ezuercher/Simple-Analog-Temperature-Sensor/Documents/TempSensor.jpg

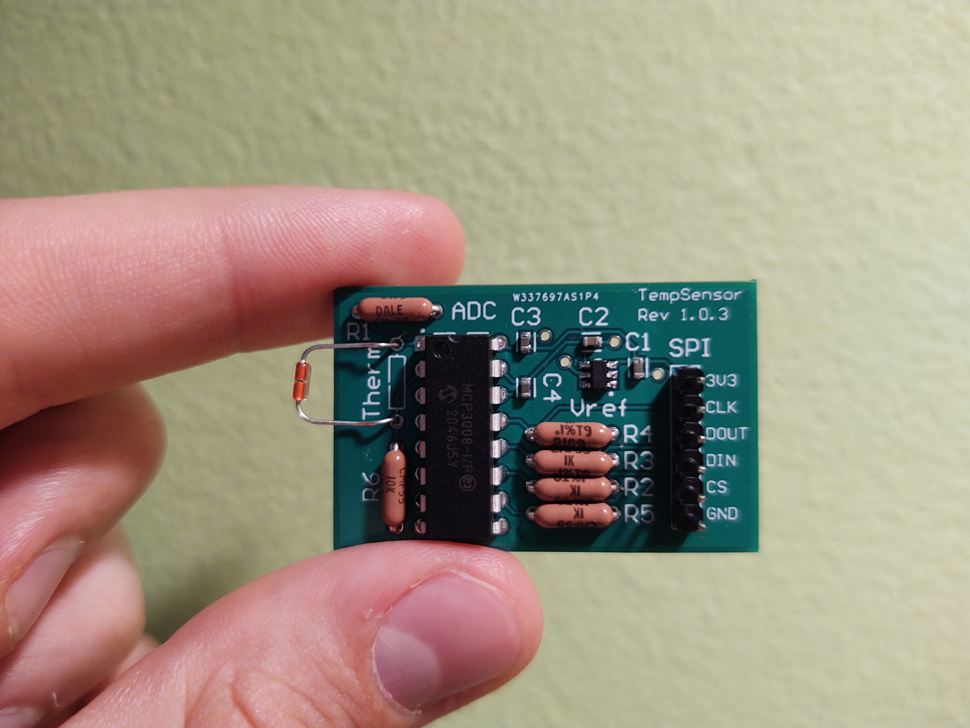
Documents/TempSensor.jpg
