ezuercher/Simple-Analog-Temperature-Sensor/README.md

# Simple-Analog-Temperature-Sensor
A simple temperature sensing unit that utilizes a thermistor and ADC.
