ezuercher/Simple-Analog-Temperature-Sensor/Documents/Screenshot.png

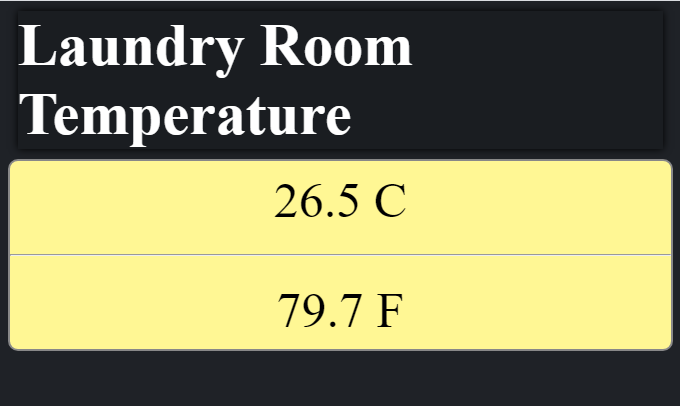
Documents/Screenshot.png
