ezuercher/Simple-Analog-Temperature-Sensor/(list of files, drawings)

Other design files:
Circuit Design/Altium/Temp_Sensor.PrjPcb
Circuit Design/Altium/TempSensor.PcbDoc
Circuit Design/Altium/TempSensor.SchDoc
