ezuercher/Simple-Analog-Temperature-Sensor/(commit log)

2022-01-26 Uploaded original files.
    [TempSensor.PcbDoc, TempSensor.SchDoc, Temp_Sensor.PrjPcb]
2025-08-20 Cleaned up the repository
    [TempSensor.PcbDoc, TempSensor.SchDoc, Temp_Sensor.PrjPcb]
